Nathan-Gu2024/rv32imac-soc/constraints/oled.xdc

set_property IOSTANDARD LVCMOS33 [get_ports {gpio_rtl_1_tri_o[0]}]
set_property IOSTANDARD LVCMOS33 [get_ports {gpio_rtl_2_tri_o[0]}]
set_property IOSTANDARD LVCMOS33 [get_ports {gpio_rtl_3_tri_o[0]}]
set_property IOSTANDARD LVCMOS33 [get_ports {gpio_rtl_4_tri_o[0]}]
set_property PACKAGE_PIN E19 [get_ports {gpio_rtl_1_tri_o[0]}]
set_property PACKAGE_PIN E18 [get_ports {gpio_rtl_2_tri_o[0]}]
set_property PACKAGE_PIN F16 [get_ports {gpio_rtl_3_tri_o[0]}]
set_property PACKAGE_PIN F17 [get_ports {gpio_rtl_4_tri_o[0]}]
