Nathan-Gu2024/rv32imac-soc/src/axi_cache_adapter.v

`ifndef _AXI_CACHE_ADAPTER_V_
`define _AXI_CACHE_ADAPTER_V_

module axi_cache_adapter #(
    parameter ADDR_WIDTH = 32,
    parameter LINE_BITS = 128,
    parameter AXI_DATA_WIDTH = 64,
    // Cycles without forward progress before a transaction is abandoned. A
    // PARAMETER rather than a constant purely so a bench can reach this path:
    // at the 4000-cycle default, forcing a timeout needs a stall no testbench
    // was ever going to write, which is exactly why the retry logic shipped
    // untested. Leave the default alone for hardware.
    parameter [15:0] TIMEOUT_LIMIT = 16'd4000
)(
    input wire clk,
    input wire rst,

    // Cache-line side: one blocking 128-bit line transaction.
    input wire mem_req_valid,
    input wire mem_req_write,
    input wire [ADDR_WIDTH-1:0] mem_req_addr,
    // Number of consecutive LINES this request covers. 1 is the historical
    // behaviour and what both caches drive. Reads only; writes ignore it.
    input wire [7:0] mem_req_lines,
    // Pulses when a WRITE burst has consumed one line and needs the next.
    // Unused by single-line requesters (both caches).
    output reg mem_wnext,
    input wire [LINE_BITS-1:0] mem_wline,
    output reg [LINE_BITS-1:0] mem_rline,
    output reg mem_ready,

    // AXI read address channel
    output reg [ADDR_WIDTH-1:0] m_axi_araddr,
    output reg [7:0] m_axi_arlen,
    output reg [2:0] m_axi_arsize,
    output reg [1:0] m_axi_arburst,
    output reg m_axi_arvalid,
    input wire m_axi_arready,

    // AXI read data channel
    input wire [AXI_DATA_WIDTH-1:0] m_axi_rdata,
    input wire m_axi_rvalid,
    input wire m_axi_rlast,
    output reg m_axi_rready,

    // AXI write address channel
    output reg [ADDR_WIDTH-1:0] m_axi_awaddr,
    output reg [7:0] m_axi_awlen,
    output reg [2:0] m_axi_awsize,
    output reg [1:0] m_axi_awburst,
    output reg m_axi_awvalid,
    input wire m_axi_awready,

    // AXI write data channel
    output reg [AXI_DATA_WIDTH-1:0] m_axi_wdata,
    output reg [AXI_DATA_WIDTH/8-1:0] m_axi_wstrb,
    output reg m_axi_wlast,
    output reg m_axi_wvalid,
    input wire m_axi_wready,

    // AXI write response channel
    input wire [1:0] m_axi_bresp,
    input wire m_axi_bvalid,
    output reg m_axi_bready
);

    // This adapter assumes the cache line is an integer multiple of the AXI data width.
    localparam integer LINE_BYTES = LINE_BITS / 8;
    localparam integer BEATS_PER_LINE = LINE_BITS / AXI_DATA_WIDTH;
    localparam integer OFFSET_BITS = $clog2(LINE_BYTES);

    localparam [7:0] AXI_LEN = BEATS_PER_LINE - 1;

    // AXI SIZE is log2(bytes per beat).
    localparam [2:0] AXI_SIZE =
        (AXI_DATA_WIDTH == 32) ? 3'b010 :
        (AXI_DATA_WIDTH == 64) ? 3'b011 :
        (AXI_DATA_WIDTH == 128) ? 3'b100 :
                                  3'b000;

    localparam [2:0] IDLE = 3'd0;
    localparam [2:0] READ_ADDR = 3'd1;
    localparam [2:0] READ_DATA = 3'd2;
    localparam [2:0] WRITE_ADDR = 3'd3;
    localparam [2:0] WRITE_DATA = 3'd4;
    localparam [2:0] WRITE_RESP = 3'd5;
    localparam [2:0] DONE = 3'd6;

    (* mark_debug = "true" *) reg [2:0] state, next_state;
    (* mark_debug = "true" *) reg [7:0] beat_count;

    (* mark_debug = "true" *) reg [ADDR_WIDTH-1:0] saved_addr;
    reg [LINE_BITS-1:0] saved_wline;
    // Snapshot of the line currently being transmitted on a multi-line burst.
    reg [LINE_BITS-1:0] wline_hold;
    (* mark_debug = "true" *) reg saved_write;
    (* mark_debug = "true" *) reg [7:0] saved_lines;
    // Registered per-line completion pulse. mem_rline is written on the beat
    // itself, so a combinational pulse on the last beat would publish a line
    // that is still one beat short. Registering it lands the pulse exactly one
    // cycle later - the same relative timing the old DONE-state pulse had.
    reg line_ready;
    // Lines of THIS REQUEST already transferred. Survives a timeout retry on
    // purpose: it is what lets a reissue resume instead of starting over.
    reg [7:0] line_sent;
    // A retry is pending/in progress, so the IDLE latch below must not treat the
    // re-presented request as a new one and clear line_sent.
    reg retrying;
    // mem_wnext has gone out for the line at line_sent, i.e. the requester's FIFO
    // head is already the NEXT line while line_sent still names this one.
    reg fifo_ahead;
    // The first line of a resumed burst must come from wline_hold, because the
    // requester has moved past it and cannot rewind.
    reg resume_hold;

    // Debug-only mirror of the input port so it can be probed directly
    // alongside mem_arbiter's own state, in the same ILA capture, to
    // check whether mem_arbiter's SVC_D/SVC_I actually reaches here.
    (* mark_debug = "true" *) wire dbg_mem_req_valid = mem_req_valid;
    (* mark_debug = "true" *) wire dbg_mem_req_write = mem_req_write;
    (* mark_debug = "true" *) wire [ADDR_WIDTH-1:0] dbg_mem_req_addr = mem_req_addr;

    wire [ADDR_WIDTH-1:0] saved_line_addr =
        {saved_addr[ADDR_WIDTH-1:OFFSET_BITS], {OFFSET_BITS{1'b0}}};

    // Where the CURRENT AXI burst starts and how long it is. On a first attempt
    // line_sent is 0 and these are the whole request; after a timeout they cover
    // only what is left, which is what makes the retry resumable rather than a
    // restart over addresses already written.
    wire [ADDR_WIDTH-1:0] lines_done_bytes =
        {{(ADDR_WIDTH-8){1'b0}}, line_sent} << OFFSET_BITS;
    wire [ADDR_WIDTH-1:0] burst_base_addr = saved_line_addr + lines_done_bytes;
    wire [7:0] burst_lines =
        (line_sent < saved_lines) ? (saved_lines - line_sent) : 8'd1;

    // Timeout/retry: confirmed via AXI Protocol Checker (rule AXI_ERRS_RID,
    // a spurious/duplicate R beat with no live matching AR) that the real
    // PS7 HP0 interconnect can occasionally leave a read's final beat
    // (or, symmetrically, a write's BRESP) unanswered forever, hanging
    // the CPU permanently. This has nothing to do with our own protocol
    // compliance (verified correct) - it's a rare interconnect condition
    // outside this RTL's control. If a transaction makes no forward
    // progress for TIMEOUT_LIMIT cycles, abandon it and drop back to
    // IDLE. mem_req_valid/mem_req_addr/mem_req_write from cache_core are
    // still held live (cache_core is itself still waiting on mem_ready),
    // so IDLE's own latch logic below reissues the identical request
    // fresh on the very next cycle - entirely transparent to cache_core,
    // which just observes a longer wait before mem_ready eventually
    // pulses. retry_count is debug-only visibility into how often this
    // actually fires.
    //
    // Restricting this to only READ_DATA/WRITE_RESP (where we're waiting
    // on the PEER's VALID signal and only hold READY ourselves, which is
    // legal to drop any time) is the protocol-clean answer, and it does
    // work - confirmed via retry_count incrementing on real hardware.
    // But the real interconnect has also been observed getting stuck in
    // READ_ADDR (ARREADY itself never arriving), which has no
    // protocol-legal recovery from the master side at all: AXI4 requires
    // ARVALID, once asserted, to stay asserted with a stable address
    // until ARREADY arrives, full stop. Given the alternative is a
    // permanent hang, this deliberately widens the timeout to every
    // non-idle/non-done state, accepting the known, intentional tradeoff
    // of occasionally violating AXI_ERRM_ARVALID_STABLE (and whatever it
    // cascades into, e.g. AXI_AUXM_RCAM_OVERFLOW) in order to actually
    // recover instead of hanging forever. The protocol checker's own
    // documentation notes RCAM_OVERFLOW specifically does not indicate a
    // functional failure of the monitored system, just that the checker
    // itself may lose track - consistent with this being a real,
    // deliberate compliance tradeoff rather than a correctness bug.
    wire timeout_eligible = (state != IDLE) && (state != DONE);
    // Any completed AXI handshake is forward progress. Counting cycles since the
    // LAST of these - rather than since the transaction began - is what the
    // comment above always described, and it stops a long but healthy burst from
    // aborting itself once BEATS_PER_LINE * lines exceeds TIMEOUT_LIMIT.
    // Waiting only on a write response, with all data already accepted.
    wire write_done_bar_bresp =
        (state == WRITE_RESP) && saved_write && (line_sent >= saved_lines);
    wire axi_progress = (m_axi_arvalid && m_axi_arready) ||
                        (m_axi_rvalid  && m_axi_rready)  ||
                        (m_axi_awvalid && m_axi_awready) ||
                        (m_axi_wvalid  && m_axi_wready)  ||
                        (m_axi_bvalid  && m_axi_bready);
    (* mark_debug = "true" *) reg [15:0] timeout_cnt;
    (* mark_debug = "true" *) reg [15:0] retry_count;

    always @(posedge clk) begin
        if (rst) begin
            state <= IDLE;
            beat_count <= 8'd0;
            saved_lines <= 8'd1;
            line_ready <= 1'b0;
            line_sent <= 8'd0;
            mem_wnext <= 1'b0;
            saved_addr <= {ADDR_WIDTH{1'b0}};
            saved_wline <= {LINE_BITS{1'b0}};
            wline_hold <= {LINE_BITS{1'b0}};
            saved_write <= 1'b0;
            mem_rline <= {LINE_BITS{1'b0}};
            timeout_cnt <= 16'd0;
            retry_count <= 16'd0;
            retrying <= 1'b0;
            fifo_ahead <= 1'b0;
            resume_hold <= 1'b0;
        end else if (timeout_eligible && timeout_cnt >= TIMEOUT_LIMIT
                     && write_done_bar_bresp) begin
            // A LOST BRESP, not a lost transfer. Every line has been accepted by
            // the slave and is in memory; only the acknowledgement never came.
            // Retrying here would re-send from a drained requester FIFO and
            // overwrite correct data, so complete instead. BRESP is ignored by
            // this adapter anyway.
            state <= DONE;
            beat_count <= 8'd0;
            timeout_cnt <= 16'd0;
            retry_count <= retry_count + 16'd1;
            line_ready <= 1'b0;
            mem_wnext <= 1'b0;
        end else if (timeout_eligible && timeout_cnt >= TIMEOUT_LIMIT) begin
            state <= IDLE;
            beat_count <= 8'd0;
            timeout_cnt <= 16'd0;
            retry_count <= retry_count + 16'd1;
            // line_sent is deliberately NOT cleared - it is the resume point.
            retrying <= 1'b1;
            // If the wnext for the line at line_sent has already gone out, the
            // requester is past it and the resumed burst must replay it from
            // wline_hold rather than from mem_wline.
            resume_hold <= fifo_ahead && saved_write;
            // These two are cleared by defaults in the else branch below, which
            // this branch never reaches - so without clearing them here they HOLD
            // through the abort and announce a transfer that did not happen.
            line_ready <= 1'b0;
            mem_wnext <= 1'b0;
        end else begin
            state <= next_state;
            timeout_cnt <= timeout_eligible
                           ? (axi_progress ? 16'd0 : timeout_cnt + 16'd1)
                           : 16'd0;

            // Latch the line transaction. After this point the upstream request
            // may drop or change without corrupting the AXI transaction.
            if (state == IDLE && mem_req_valid) begin
                saved_addr <= mem_req_addr;
                saved_write <= mem_req_write;
                saved_lines <= (mem_req_lines == 8'd0) ? 8'd1 : mem_req_lines;
                beat_count <= 8'd0;
                // A retry re-presents the SAME request, so line_sent must survive
                // it; only a genuinely new request starts from line 0. saved_wline
                // likewise must not be re-sampled, because on a resume mem_wline
                // is no longer the line this address needs.
                if (!retrying) begin
                    line_sent   <= 8'd0;
                    saved_wline <= mem_wline;
                    fifo_ahead  <= 1'b0;
                end
                retrying <= 1'b0;
            end

            // Pack AXI read beats into the 128-bit cache line. beat_count is
            // the index WITHIN the current line, so it wraps every
            // BEATS_PER_LINE and a multi-line burst reuses the same packing.
            line_ready <= 1'b0;
            if (state == READ_DATA && m_axi_rvalid && m_axi_rready) begin
                mem_rline[beat_count*AXI_DATA_WIDTH +: AXI_DATA_WIDTH] <= m_axi_rdata;
                if (beat_count == BEATS_PER_LINE - 1) begin
                    beat_count <= 8'd0;
                    line_ready <= 1'b1;   // one line complete, publish next cycle
                    // Reads need the same progress count as writes, otherwise a
                    // resumed read reissues from line 0 and re-delivers lines the
                    // requester has already consumed.
                    line_sent  <= line_sent + 8'd1;
                end else begin
                    beat_count <= beat_count + 8'd1;
                end
            end

            // Freeze the line being transmitted.
            //
            // m_axi_wdata sliced mem_wline LIVE on multi-line bursts, which is
            // only safe while mem_wline holds still for a whole line. It does
            // not: mem_wnext is pulsed one beat EARLY so the requester's FIFO
            // can present the next line in time, so mem_wline changes while
            // this line's last beat is still outstanding. Against a slave that
            // accepts a beat every cycle that beat has already gone and
            // nothing shows - which is why this survived a bitstream, a board
            // run and every existing testbench. Deassert WREADY for a single
            // cycle, which AXI4 permits a slave to do at any time, and the
            // last beat of every line carries the NEXT line's bytes.
            //
            // Beat 0 keeps slicing mem_wline directly: beat_count wraps to 0 on
            // the same edge the next line appears, so the latch is one cycle
            // behind at exactly that point.
            // Not while resume_hold is owed: wline_hold IS the line being
            // replayed, and mem_wline has already moved on.
            if (state == WRITE_DATA && beat_count == 8'd0 && !resume_hold)
                wline_hold <= mem_wline;

            // Advance the write beat counter, wrapping per LINE so a burst
            // reuses the same slicing. mem_wnext pulses on each wrap so the
            // requester can present the next line.
            mem_wnext <= 1'b0;
            if (state == WRITE_DATA && m_axi_wvalid && m_axi_wready) begin
                if (beat_count == BEATS_PER_LINE - 1) begin
                    beat_count <= 8'd0;
                    line_sent  <= line_sent + 8'd1;
                    // This line is now accounted for in line_sent, so the FIFO is
                    // no longer ahead of it, and a replay of it is no longer owed.
                    fifo_ahead  <= 1'b0;
                    resume_hold <= 1'b0;
                end else begin
                    beat_count <= beat_count + 8'd1;
                end
                // One beat EARLY: the requester's FIFO needs a cycle to present
                // the next line, and the next line's first beat follows
                // immediately after this line's last one.
                if ((beat_count == BEATS_PER_LINE - 2) &&
                    (line_sent + 8'd1 < saved_lines)) begin
                    mem_wnext <= 1'b1;
                    fifo_ahead <= 1'b1;   // requester now past line_sent
                end
            end

            if (state == DONE) begin
                beat_count <= 8'd0;
            end
        end
    end

    always @(*) begin
        next_state = state;

        case (state)
            IDLE: 
                begin
                    if (mem_req_valid) begin
                        if (mem_req_write)
                            next_state = WRITE_ADDR;
                        else
                            next_state = READ_ADDR;
                    end
                end

            READ_ADDR: 
                begin
                    if (m_axi_arvalid && m_axi_arready)
                        next_state = READ_DATA;
                end

            READ_DATA:
                begin
                    if (m_axi_rvalid && m_axi_rready && m_axi_rlast)
                        next_state = DONE;
                end

            WRITE_ADDR: 
                begin
                    if (m_axi_awvalid && m_axi_awready)
                        next_state = WRITE_DATA;
                end

            WRITE_DATA:
                begin
                    if (m_axi_wvalid && m_axi_wready && m_axi_wlast)
                        next_state = WRITE_RESP;
                end

            WRITE_RESP: 
                begin
                    if (m_axi_bvalid && m_axi_bready)
                        next_state = DONE;
                end

            DONE: 
                begin
                    next_state = IDLE;
                end
            default: next_state = IDLE;
        endcase
    end

    always @(*) begin
        m_axi_araddr = burst_base_addr;
        // Span every line of the request in ONE transaction: that is the
        // point of the burst, since the ~30-cycle round trip is paid per
        // transaction rather than per beat.
        m_axi_arlen = (saved_lines * BEATS_PER_LINE) - 8'd1;
        m_axi_arsize = AXI_SIZE;
        m_axi_arburst = 2'b01; // INCR
        m_axi_arvalid = 1'b0;

        m_axi_rready = 1'b0;

        m_axi_awaddr = burst_base_addr;
        m_axi_awlen = (burst_lines * BEATS_PER_LINE) - 8'd1;
        m_axi_awsize = AXI_SIZE;
        m_axi_awburst = 2'b01; // INCR
        m_axi_awvalid = 1'b0;

        m_axi_wdata = {AXI_DATA_WIDTH{1'b0}};
        m_axi_wstrb = {(AXI_DATA_WIDTH/8){1'b1}}; // full-line dirty eviction
        m_axi_wlast = 1'b0;
        m_axi_wvalid = 1'b0;

        m_axi_bready = 1'b0;

        // Reads complete a line at a time, so they pulse from line_ready.
        // Writes still pulse once in DONE. Splitting these keeps a single-line
        // read at exactly one pulse with unchanged timing rather than firing
        // from both sources.
        // QUALIFIED BY STATE. line_ready is a register, and the timeout path
        // used to leave it set while dropping to IDLE, which published a line
        // completion for a line that never arrived.
        mem_ready = line_ready && ((state == READ_DATA) || (state == DONE));
        case (state)
            READ_ADDR: 
                begin
                    m_axi_arvalid = 1'b1;
                end

            READ_DATA: 
                begin
                    m_axi_rready = 1'b1;
                end

            WRITE_ADDR: 
                begin
                    m_axi_awvalid = 1'b1;
                end
            WRITE_DATA: 
                begin
                    m_axi_wvalid = 1'b1;
                    // Single-line writes slice the latched copy, keeping the
                    // cache path bit-identical. Multi-line bursts take beat 0
                    // from mem_wline and every later beat from the frozen copy,
                    // so a slave that stalls mid-line cannot pull in bytes from
                    // the line the requester has already advanced to.
                    m_axi_wdata = (saved_lines == 8'd1)
                        ? saved_wline[beat_count*AXI_DATA_WIDTH +: AXI_DATA_WIDTH]
                        // resume_hold: the requester already advanced past this
                        // line, so BOTH beats come from the frozen copy.
                        : (resume_hold
                            ? wline_hold[beat_count*AXI_DATA_WIDTH +: AXI_DATA_WIDTH]
                            : (beat_count == 8'd0
                                ? mem_wline[beat_count*AXI_DATA_WIDTH +: AXI_DATA_WIDTH]
                                : wline_hold[beat_count*AXI_DATA_WIDTH +: AXI_DATA_WIDTH]));
                    // WLAST marks the end of the whole burst, not of a line.
                    // line_sent is absolute and saved_lines is the whole
                    // request, so this still marks the end of the REQUEST, which
                    // after a resume is also the end of the shortened burst.
                    m_axi_wlast = (beat_count == AXI_LEN) &&
                                  (line_sent == saved_lines - 8'd1);
                end
            WRITE_RESP: 
                begin
                    m_axi_bready = 1'b1;
                end
            DONE: 
                begin
                    // Writes only: reads already pulsed per line above.
                    if (saved_write) mem_ready = 1'b1;
                end
        endcase
    end

endmodule

`endif // _AXI_CACHE_ADAPTER_V_
