Nathan-Gu2024/rv32imac-soc/src/mem_arbiter.v

`ifndef _MEM_ARBITER_V_
`define _MEM_ARBITER_V_

module mem_arbiter (
    input wire clk, 
    input wire rst,

    // icache 
    input wire icache_req_valid,
    input wire [31:0] icache_req_addr,
    output wire icache_ready,
    output wire [127:0] icache_rline,

    // dcache 
    input wire dcache_req_valid, dcache_req_write,
    input wire [31:0] dcache_req_addr,
    input wire [127:0] dcache_wline,
    output wire dcache_ready,
    output wire [127:0] dcache_rline,

    // accelerator result DMA - third requester, same one-outstanding-request
    // contract as the two caches. mm_accel drains its accumulators here as
    // 128-bit lines instead of through its 32-bit AXI4-Lite register window,
    // which measured 70% of GEMM runtime at DIM=16.
    //
    // accel_req_write exists for Phase 2 (operand fetch); Phase 1 only writes.
    // Tie accel_req_valid low to get exactly the previous two-port behaviour.
    input wire accel_req_valid, accel_req_write,
    input wire [31:0] accel_req_addr,
    // Consecutive LINES this accelerator request covers. Only the accelerator
    // bursts; both caches are inherently single-line and are pinned to 1 below,
    // so their timing through the adapter is bit-for-bit what it was.
    input wire [7:0] accel_req_lines,
    input wire [127:0] accel_wline,
    output wire accel_ready,
    // Per-line write handshake for burst writes: the adapter asks for the next
    // line, and only the accelerator can answer (the caches are single-line).
    output wire accel_wnext,
    output wire [127:0] accel_rline,

    // main mem / DDR
    output wire mem_req_valid, mem_req_write,
    output wire [31:0] mem_req_addr,
    output wire [7:0] mem_req_lines,
    output wire [127:0] mem_wline,
    input wire mem_ready,
    input wire mem_wnext,
    input wire [127:0] mem_rline
);

    localparam IDLE = 2'b00;
    localparam SVC_D = 2'b01;
    localparam SVC_I = 2'b10;
    localparam SVC_A = 2'b11;   // accelerator result DMA

    localparam LAST_D = 2'd0;
    localparam LAST_I = 2'd1;
    localparam LAST_A = 2'd2;

    (* mark_debug = "true" *) reg [1:0] state;

    reg saved_req_write;
    reg [7:0] saved_req_lines;
    (* mark_debug = "true" *) reg [7:0] line_count;
    reg [31:0] saved_req_addr;
    reg [127:0] saved_wline;

    // Round-robin fairness: each cache can only ever have one outstanding
    // request at a time (both stall their own pipeline side until their
    // own mem_ready), so this never affects a lone requester - it only
    // matters on the rare cycle both are pending simultaneously, where
    // dcache used to always win outright. Not the fix for the confirmed
    // AXI_ERRS_RID hang (that's downstream in axi_cache_adapter, already
    // fixed there via timeout/retry), but removes a real, if narrow,
    // starvation risk under sustained concurrent traffic.
    // Extended from a single bit to a 3-way rotating priority when the
    // accelerator DMA became a third requester. Whoever was granted last drops
    // to the back of the queue, so no requester can be starved by the other
    // two alternating - which a fixed priority order would allow, and which is
    // the exact failure mode the two-port round-robin was introduced to remove.
    //
    //   last = D  ->  I, A, D
    //   last = I  ->  A, D, I
    //   last = A  ->  D, I, A
    (* mark_debug = "true" *) reg [1:0] last_granted;

    (* mark_debug = "true" *) wire grant_d = (state == IDLE) && dcache_req_valid &&
        ((last_granted == LAST_A) ? 1'b1                                        // first
       : (last_granted == LAST_I) ? !accel_req_valid                            // second
       :                            (!icache_req_valid && !accel_req_valid));   // third
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
