Nathan-Gu2024/rv32imac-soc/(commit log)

2026-06-21 UART modules and tb
2026-06-21 Verified uart with vivado
2026-06-24 Complete ASIC flow
2026-06-26 Complete and tested HW trap and context switch
2026-06-26 Added core local interrupt timer
2026-07-25 Working LEDs with current files
2026-07-26 Passed TCM load/store, TODO: comprehensive mem test, UART printf, Run C prog (TCM -> DDR), boot zephyr
2026-07-30 Linker, crt0s, simple LED for vivado
2026-07-31 Fixed bugs in cpu flow
    [cpu.v, dcache.v, hazard_unit.v, icache.v, master.xdc, tb.v]
2026-08-02 Fixed 60 second delay in LED, TODO: Fix reading from .mem file
    [cache_core.v, cpu.v, csr_file.v, dcache.v, fpga_top.v, icache.v, main.asm, main.c]
2026-08-03 Fixed timing with div_unit, verified IM extensions on FPGA
    [alu.v, control_logic.v, cpu.v, div_unit.v, main.asm, main.c, tb_debug.v, tcm.v]
2026-08-04 Functioning basic uart from zynq7020
2026-08-05 end to end success of uart, completed rx, putty displays text from kboard
2026-08-06 Fixed icache and added basic tests for proper DDR functionality, must dow data on vitis before bitstreaming on vivado to work
    [ddr_test.c, icache.v]
2026-08-09 Basic drivers implemented and tested via dining philosopher, uart echo, hello world through zephyr rtos, TODO: test zephyr more and validate interrupts more
2026-08-22 Reorganize fpga/ into rtl/tests/zephyr/linker subdirectories
    Groups the flat fpga/ directory into rtl/ (synthesizable top-level
    sources), tests/ (bare-metal test programs and their build artifacts),
    zephyr/ (RTOS board-port binaries), and linker/ (linker scripts) for
    clarity as the number of FPGA-side files has grown.
2026-08-22 Harden AXI cache adapter timeout/retry and arbiter fairness
    axi_cache_adapter.v: add a timeout/retry mechanism so a stuck AXI
    transaction (interconnect hiccup) recovers instead of permanently
    hanging the pipeline, validated against a deliberately-sabotaged mock
    AXI slave in simulation and confirmed recovering on real hardware.
    mem_arbiter.v: round-robin fairness between icache/dcache requests
    instead of dcache holding strict priority, to avoid icache starvation
    under sustained data traffic.
    [axi_cache_adapter.v, mem_arbiter.v]
2026-08-22 Add static branch prediction and full RV32A atomics
    Branch predictor: backward-taken/forward-not-taken static prediction
    in ID, using the already-decoded B-type immediate - no dependency on
    same-cycle icache/TCM fetch data. Gated on the load-use stall and
    global_mem_stall so a stalled or in-flight instruction can't be
    mispredicted-redirected out from under itself. Measured +4.16%
    CoreMark on real hardware over the unpredicted baseline.
    Full RV32A atomics: AMOSWAP/ADD/XOR/AND/OR/MIN/MAX/MINU/MAXU were
    previously stubbed to silently execute as a plain ADD with no memory
    access at all (only LR/SC were real). Adds a small sequencer in MEM
    that issues its own two-phase dcache read-then-write (re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
    [control_logic.v, cpu.v, fpga_top.v]
2026-08-22 Add CoreMark benchmark port and sim verification harness
    Bare-metal CoreMark port (core_portme.c/ee_printf.c/cvt.c against the
    upstream EEMBC core_main.c/core_list_join.c/core_matrix.c/core_state.c/
    core_util.c) targeting this CPU's TCM-boot-stub-then-DDR flow, reusing
    the existing crt0.S/linker_ddr.ld. Measured 117.43 Iterations/Sec
    (2.35 CoreMark/MHz) on real hardware with the branch predictor and
    atomics from the previous commit, CRCs matching the official golden
    reference exactly.
    Sim harness (Testbenches/tb_coremark_sim.v + baseline counterpart):
    mock DDR memory behind the icache/dcache line interfaces with a fixed
    per-line latency, the real TCM boot stub, and a UART-transmit snoop
    (re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
    [bin_to_memh.py, core_list_join.c, core_portme.c, core_portme.h, cpu_baseline.v, ee_printf.c, tb_coremark_sim.v, tb_coremark_sim_baseline.v]
2026-08-22 Add AMO test suite (assembly + C)
    Two independent tests exercising all 9 AMOSWAP/ADD/XOR/AND/OR/MIN/MAX/
    MINU/MAXU operations against known operands, checking both the old
    value returned to rd and the new value actually committed to memory:
    - test_amo.S: hand-written assembly, verified via Testbenches/
    tb_amo_test.v's register-peek checks in simulation.
    - test_amo.c: C version built two ways - test_amo_c_sim (sim-only
    linker, verified via tb_amo_c_test.v) and test_amo_hw (real
    linker_ddr.ld, for flashing to hardware the same way as the other
    fpga/tests/ binaries).
    All 18 checks pass in both tests.
2026-08-28 3.07CoreMark/MHz 171 iterations / sec, BRAM converison, IF stage gshare, Zba, 55.5MHz
2026-08-28 3.17 CoreMark/MHz, 1.486W, BRAM dcache, mulhsu fix, is_div_op fix 176 iterations / sec
    [cpu.v, dcache.v, dcache_bram.v, tb_dcache.v, tb_dcache_hazard.v, tb_icache.v]
2026-09-02 Signed off initial ASIC, converted code to ASIC from FPGA
    [macro_placement.cfg]
2026-09-04 ASIC flop vs macro, signed off
    [macro_placement.cfg]
2026-09-08 Chisel MmAccel file, Openlane infra and Chisel generator with tbs
    [macro_placement.cfg, pin_order.cfg]
2026-09-08 Updated tbs, mm_accel core swap to DIM=8
    [cpu.v, fpga_top.v, mem_arbiter.v, tb_irqtest.v, tb_mem_arbiter.v, tb_mm_accel.v, tb_mm_accel_bench.v]
2026-09-10 FIFO, scratchpad, double buffer, operand DMA addition in Scala; tested and validated metrics on FPGA; added more tbs
2026-09-11 Resolved protocol bug in axi_cache_adapter
    [axi_cache_adapter.v]
2026-09-11 Updated MmAccel design for maxK=64, SRAM buffers, queue groundwork
2026-09-11 Update test_mm_accel.c for INT8, panel alignment, lane pitch
2026-09-11 Add queue/DMA tbs and updated existing test suites
2026-09-22 Zephyr port addition of mm accell as os device
2026-09-22 Included guards and fixed back to back atomic operations; new testbenches
    [accel_port_join.v, alu.v, axi_cache_adapter.v, axi_lite_bridge.v, axi_rw_engine.v, branch_comp.v, cache_core.v, clint_timer.v]
